CloudEngineHub/handumi-hw/hardware/STEP/right_handumi/handumi-main-support.step

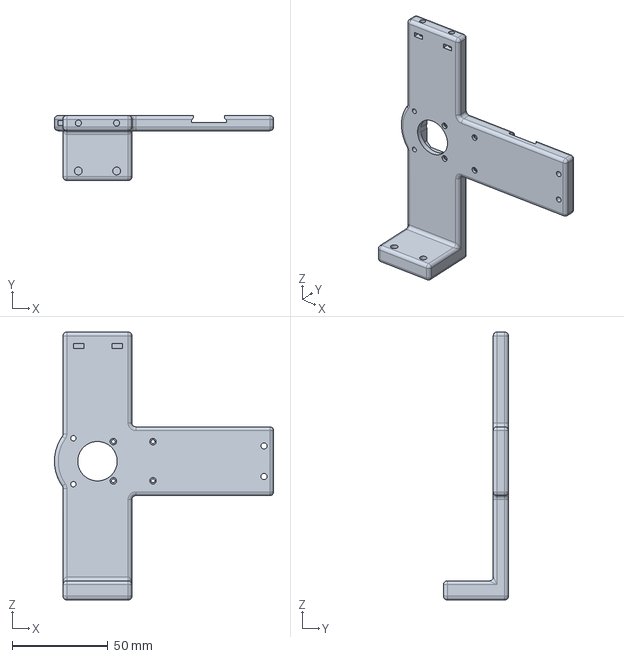
[picture p2: CAD file, 2026-10-20]
hardware/STEP/right_handumi/handumi-main-support.step
114.5 x 34.0 x 140.0 mm
