CloudEngineHub/handumi-hw/hardware/STEP/gripper_tips/Galaxea-R1-Lite/Galaxea-R1-Lite.step

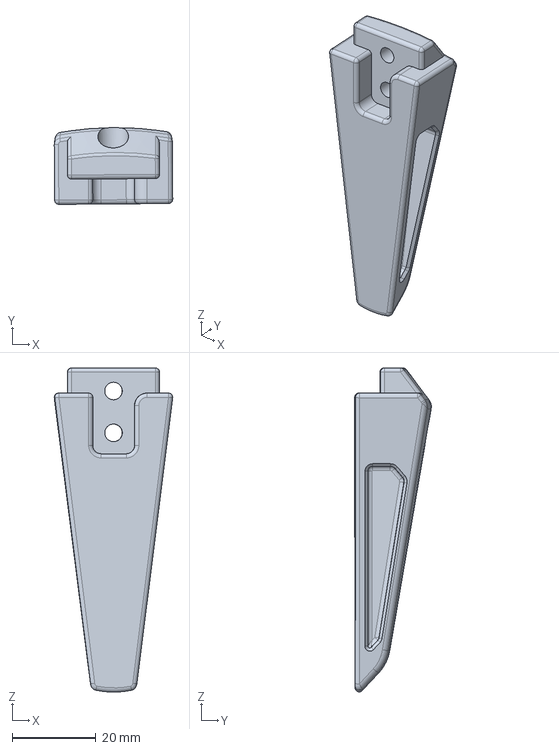
[picture p3: CAD file, 2026-10-20]
hardware/STEP/gripper_tips/Galaxea-R1-Lite/Galaxea-R1-Lite.step
28.3 x 18.4 x 77.4 mm
