CloudEngineHub/handumi-hw/hardware/STEP/gripper_tips/I2RT-YAM/I2RT Left Tip.step

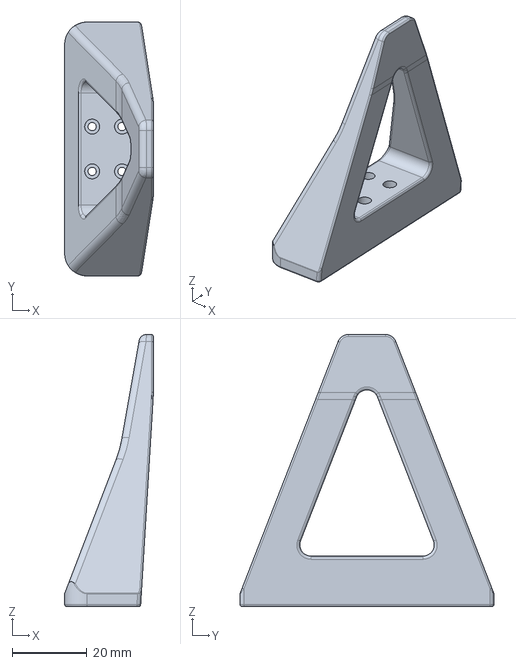
[picture p4: CAD file, 2026-10-20]
hardware/STEP/gripper_tips/I2RT-YAM/I2RT Left Tip.step
23.7 x 68.0 x 72.8 mm
