CloudEngineHub/handumi-hw/hardware/STEP/gripper_tips/MakerMods-Metal/metal-arm-gripper-tip.step

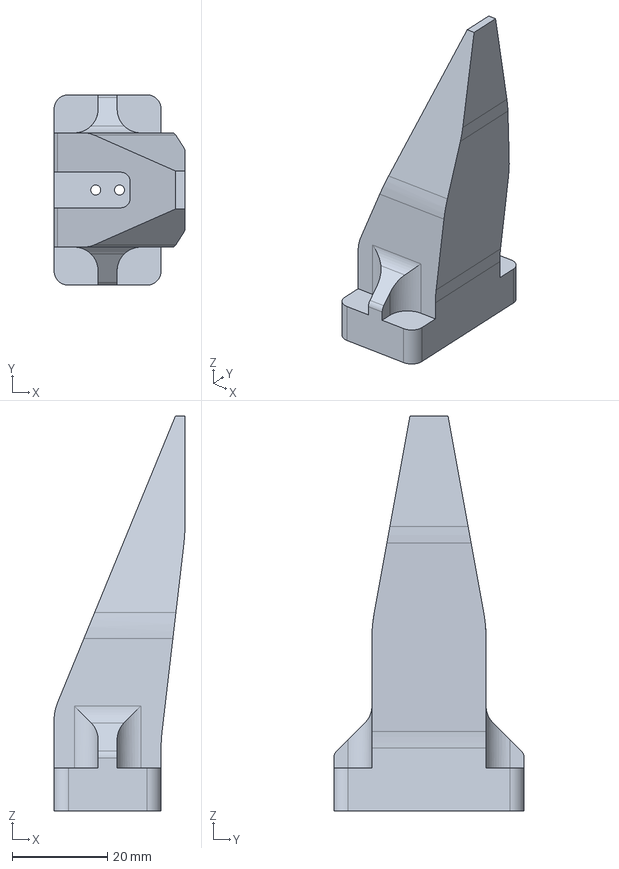
[picture p5: CAD file, 2026-10-20]
hardware/STEP/gripper_tips/MakerMods-Metal/metal-arm-gripper-tip.step
27.5 x 40.0 x 83.0 mm
