CloudEngineHub/handumi-hw/hardware/STEP/left_handumi/left_controller_support_pico.step

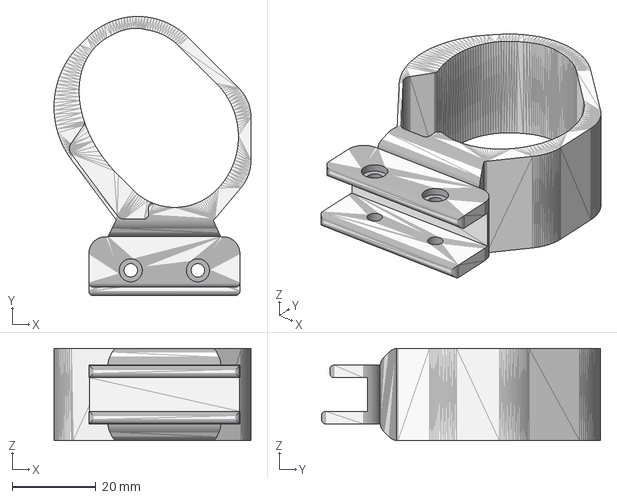
[picture p6: CAD file, 2026-11-05]
hardware/STEP/left_handumi/left_controller_support_pico.step
46.9 x 66.5 x 22.0 mm
