CloudEngineHub/handumi-hw/hardware/STL/gripper_tips/Galaxea-R1-Lite/Galaxea-R1-Lite-left.stl

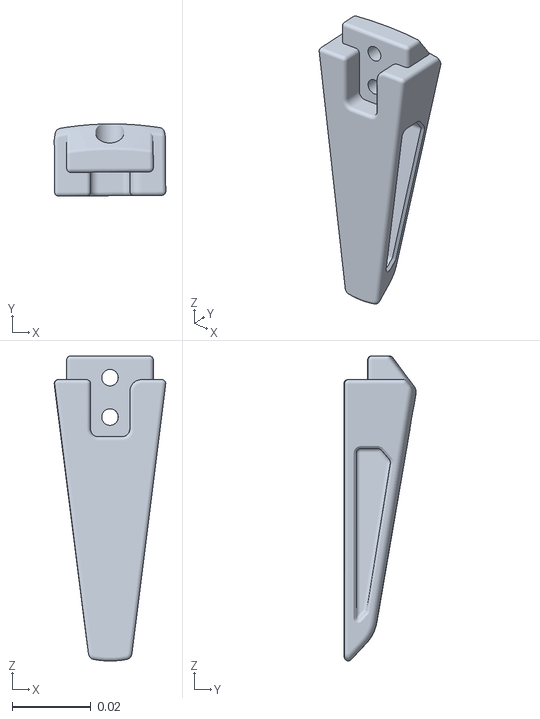
[picture p7: CAD file, 2026-10-20]
hardware/STL/gripper_tips/Galaxea-R1-Lite/Galaxea-R1-Lite-left.stl
0.0283 x 0.0184 x 0.0774
