CloudEngineHub/handumi-hw/hardware/STL/gripper_tips/I2RT-YAM/I2RT-Right-Tip.stl

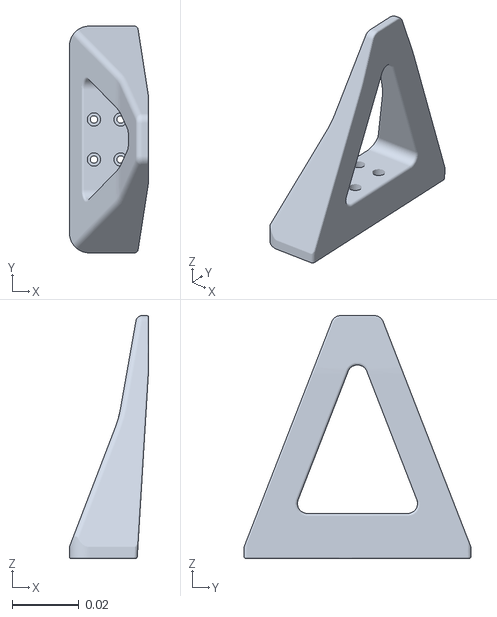
[picture p8: CAD file, 2026-10-20]
hardware/STL/gripper_tips/I2RT-YAM/I2RT-Right-Tip.stl
0.0237 x 0.068 x 0.0728
