CloudEngineHub/handumi-hw/hardware/STL/gripper_tips/MakerMods-Metal/metal-arm-gripper-tip-left.stl

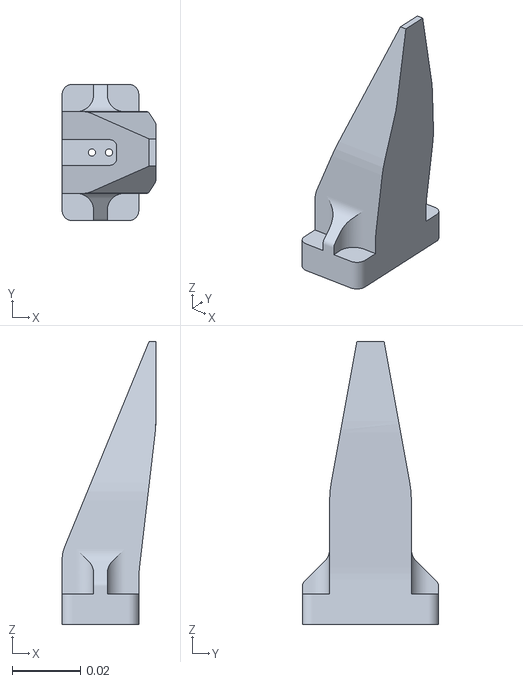
[picture p9: CAD file, 2026-10-20]
hardware/STL/gripper_tips/MakerMods-Metal/metal-arm-gripper-tip-left.stl
0.0275 x 0.04 x 0.083
