CloudEngineHub/handumi-hw/hardware/STL/gripper_tips/OpenArmv1/OpenArm-right.stl

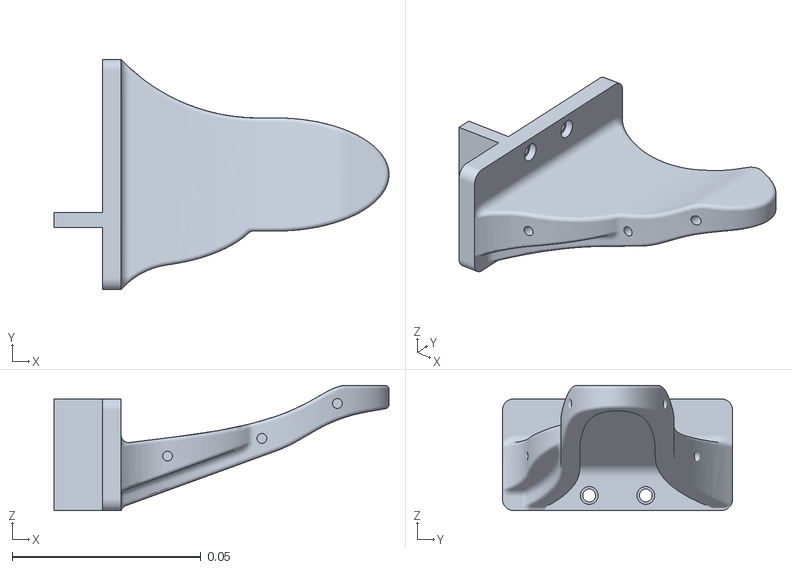
[picture p10: CAD file, 2026-10-20]
hardware/STL/gripper_tips/OpenArmv1/OpenArm-right.stl
0.0888 x 0.061 x 0.0332
