CloudEngineHub/handumi-hw/hardware/STL/left_handumi/left_controller_support_meta.stl

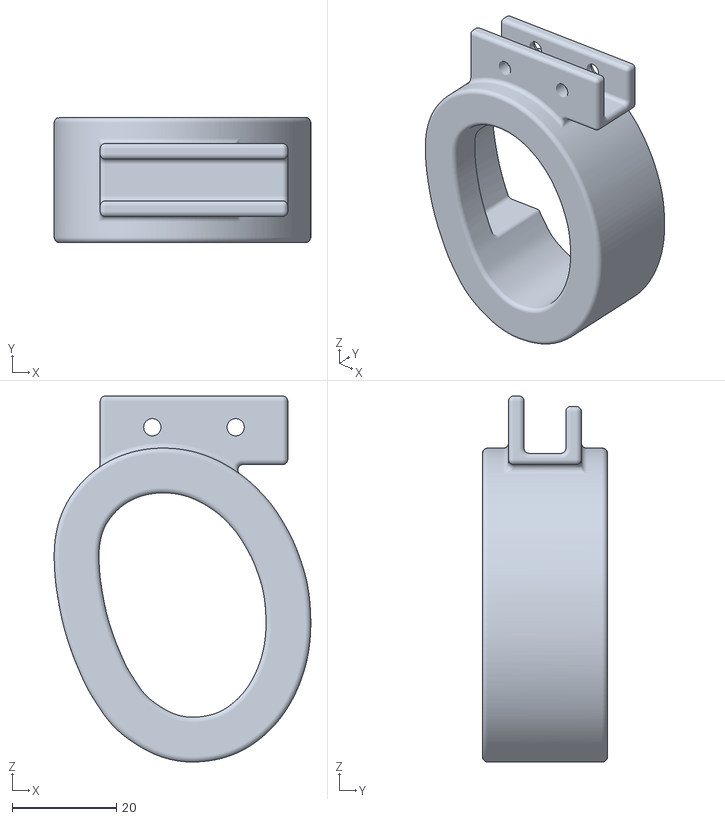
[picture p11: CAD file, 2026-11-05]
hardware/STL/left_handumi/left_controller_support_meta.stl
49.2 x 24.0 x 70.2
