CloudEngineHub/handumi-hw/hardware/STEP/left_handumi/hand_support_base.step

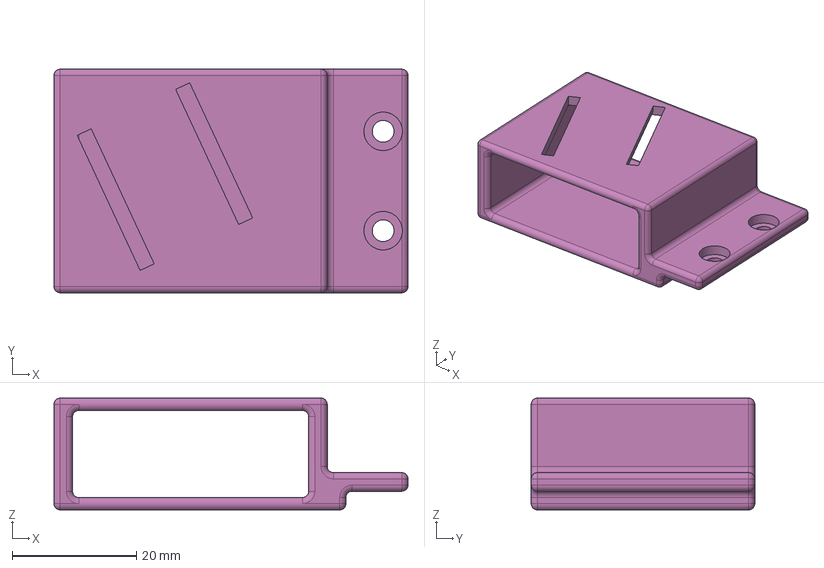
[picture p12: CAD file, 2026-10-20]
hardware/STEP/left_handumi/hand_support_base.step
57.0 x 36.0 x 18.0 mm
