CloudEngineHub/handumi-hw/hardware/STEP/right_handumi/camera_cover.step

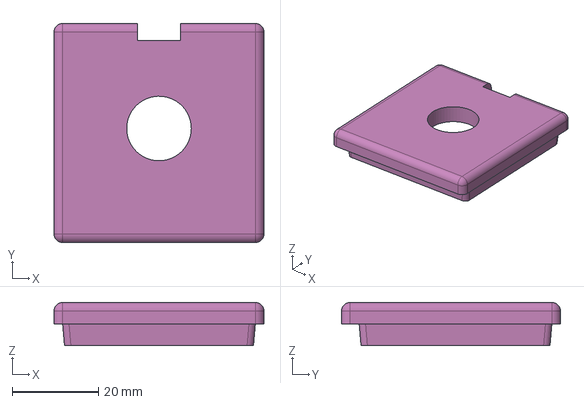
[picture p13: CAD file, 2026-10-20]
hardware/STEP/right_handumi/camera_cover.step
48.8 x 50.9 x 10.0 mm
