CloudEngineHub/handumi-hw/hardware/STL/left_handumi/hand_support_foam_pad.stl

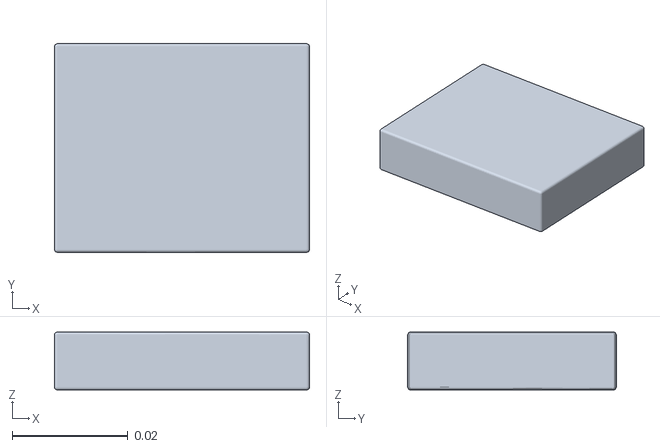
[picture p14: CAD file, 2026-10-20]
hardware/STL/left_handumi/hand_support_foam_pad.stl
0.044 x 0.036 x 0.01
