CloudEngineHub/handumi-hw/hardware/STEP/left_handumi/handumi-camera-support.step

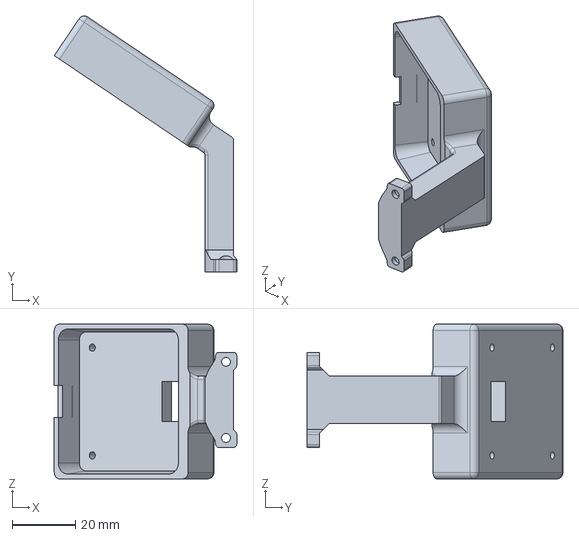
[picture p15: CAD file, 2026-10-20]
hardware/STEP/left_handumi/handumi-camera-support.step
57.6 x 80.7 x 48.8 mm
