CloudEngineHub/handumi-hw/(list of files, cad)

Other CAD files:
hardware/STEP/right_handumi/right_controller_support_pico.step
hardware/STL/right_handumi/right_controller_support_meta.stl
hardware/STL/left_handumi/camera_cover.stl
hardware/STL/left_handumi/hand_support_base.stl
hardware/STL/left_handumi/handumi-camera-support.stl
hardware/STL/left_handumi/handumi-main-support.stl
hardware/STL/left_handumi/left_controller_support_pico.stl
hardware/STL/right_handumi/camera_cover.stl
hardware/STL/right_handumi/hand_support_base.stl
hardware/STL/right_handumi/handumi-camera-support.stl
hardware/STL/right_handumi/handumi-main-support.stl
hardware/STL/right_handumi/right_controller_support_pico.stl
