CloudEngineHub/handumi-hw/(commit log)

2026-09-12 docs(bom): price BOM per pair, switch camera to IMX335, add part specs
    - BOM (README, PDF, DOCX) now covers a pair of HandUMI units
    - Camera changed to SVPRO IMX335 USB camera from AliExpress ($50.69)
    - Part names include code and dimensions (MR63ZZ 3x6x2.5 mm, LM4UU 4x8x12 mm, Ø4 mm axle, STS3215 7.4 V, 5 V supply)
    - Linear bearing and M3 kit Amazon links updated
    - Main README price references updated (~$104 per unit, ~$207 per pair)
2026-10-19 docs: add paper section, figures and assembly guide
    Add the HandUMI paper section to the README (authors, project website,
    Hugging Face data and checkpoints, Quest app, towel-folding results and
    paper figures), plus citation and acknowledgments. State Quest 3/3S
    support and the USD 557 pair price with Quest 3S, and mention the
    optional ZED Mini workspace view.
    Add the left-hand assembly guide under hardware/ and link it from both
    READMEs, noting that the camera support now uses M2 instead of M2.5
    fasteners.
    Drop the robot-mounted deployment unit from the hardware README: the
    robot keeps its installed gripper. Point CONTRIBUTING at handumi-sw.
2026-10-19 docs: move towel-folding results to the software README
    Keep the hardware README focused on the device and link to handumi-sw
    for the policy results, which now hold Fig. 2.
2026-10-20 Updated STL and STEP files for gripper tips and handumi left & hardware
    [Galaxea-R1-Lite-left.stl, Galaxea-R1-Lite-right.stl, Galaxea-R1-Lite.step, I2RT Left Tip.step, I2RT-Left-Tip.stl, I2RT-Right-Tip.stl, OpenArm-left.stl, OpenArm-right.stl]
2026-11-05 pico controller support stl files
    [left_controller_support_meta.stl, left_controller_support_pico.step, left_controller_support_pico.stl, right_controller_support_meta.stl, right_controller_support_pico.step, right_controller_support_pico.stl]
